movhdi/buck/شماتیک مدار اصلی قدرت مبدل باک.png

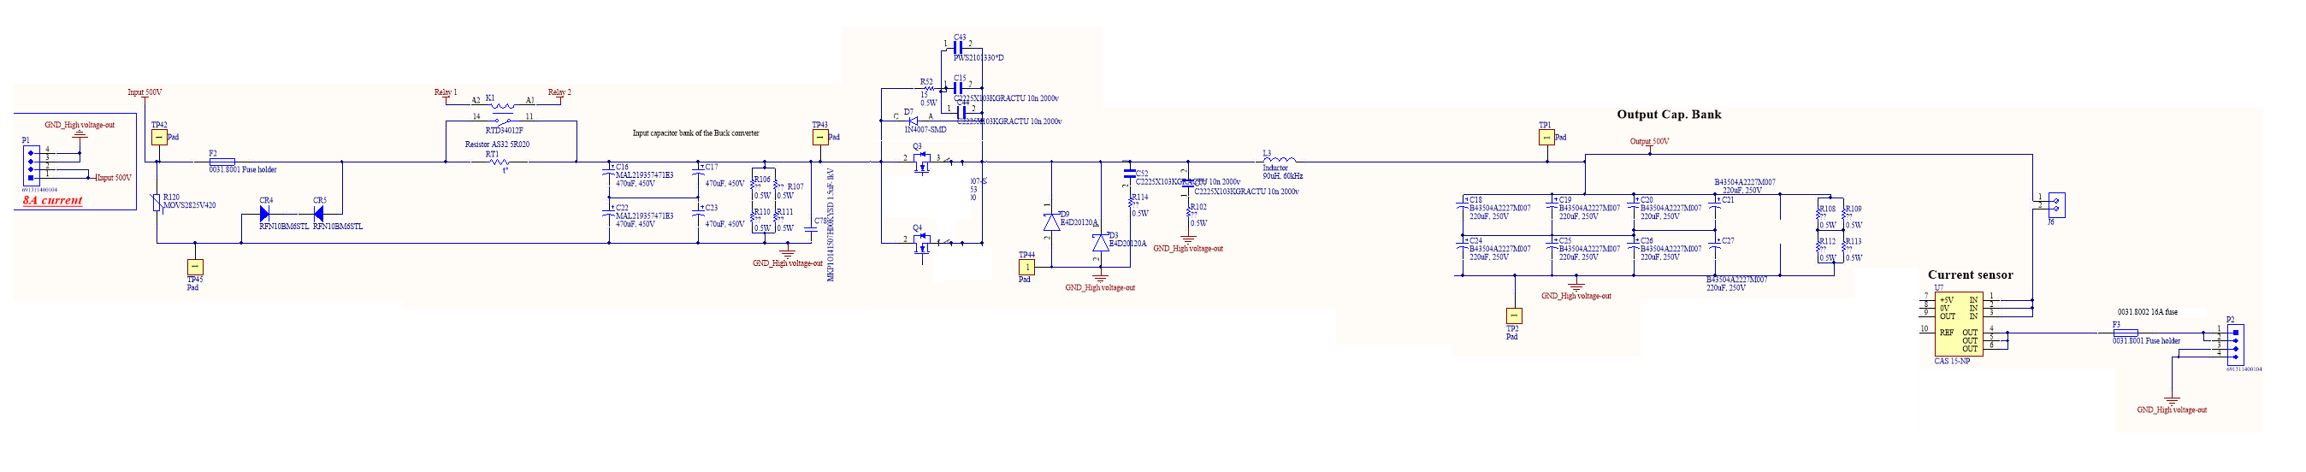
شماتیک مدار اصلی قدرت مبدل باک.png
