movhdi/buck/Final BOM 23.12.2022 for Library.xls

Sheet: Buck Converter
Pos | Count | Name | Type | Package (inch) | Value | Description | Manufacturer | Manuf. Part Number | Distributor | Distributor - PartNumber
1 | 4 | C1, C2, C9, C10 | SMD MLCC | 0805 | 1nF, 50V, X7R, 10% | Capacitor | Samsung | CL21B103KBANFNC | Mouser (https://www.mouser.de/ProductDetail/Samsung-Electro-Mechanics/CL21B103KBANFNC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) | 187-CL21B103KBANFNC
2 | 10 | C3, C4, C6, C8, C13, C14, C29, C30, C42, C71 | SMD MLCC | 0805 | 100nF, 50V, X7R, 10% | Capacitor | Kyocera AVX | 08055C104KAT2A | Mouser (https://www.mouser.de/ProductDetail/KYOCERA-AVX/08055C104KAT2A?qs=2ujN4bDBNE9mJvapP%252BjopA%3D%3D) | 581-08055C104K
3 | 4 | C5, C7, C11, C12 | SMD MLCC | 0805 | 100pF, 1000V, C0G, 10% | Capacitor | Kemet | C0805C101KDGACAUTO | Mouser (https://www.mouser.de/ProductDetail/KEMET/C0805C101KDGACAUTO?qs=ds50AKTGxA%252BLPSx5ZuVIbw%3D%3D) | 80-C0805C101KDGAUTO
4 | 4 | C15, C44, C52, C77 | SMD MLCC | 2225 (5664 metric) | 10nF, 2000V, X7R, 10% | Capacitor | Kemet | C2225X103KGRACTU | Mouser (https://www.mouser.de/ProductDetail/KEMET/C2225X103KGRACTU?qs=QuKtCJqbFLqTW8HohInyGA%3D%3D) | 80-C2225X103KGR
5 | 4 | C16, C17, C22, C23 | Polarized Capacitor | 35 x 50 mm (axial) | 470uF, 450V | Alu-Elektrolytkondensatoren - einrastend | Vishay | MAL219357471E3 | Mouser (https://www.mouser.de/ProductDetail/Vishay-BC-Components/MAL219357471E3?qs=GedFDFLaBXHGPbG7as%2FOlA%3D%3D) | 594-MAL219357471E3
6 | 8 | C18, C19, C20, C21, C24, C25, C26, C27 | Polarized Capacitor | 22 x 30 mm (axial) | 220uF, 250V, 20% | Alu-Elektrolytkondensatoren - einrastend | Epcos / TDK | B43504A2227M007 | Mouser (https://www.mouser.de/ProductDetail/EPCOS-TDK/B43504A2227M007?qs=f4aWRLuQiuw%2FgInPUHtBEw%3D%3D) | 871-B43504A2227M007
7 | 25 | C28, C34, C35, C36, C37, C38, C39, C40, C47, C48, C53, C54, C55, C56, C57, C58, C60, C61, C62, C63, C64, C66, C67, C68, C69 | Polarized Capacitor | 6.3 x 5.3mm | 47uF, 16V, 20% | Alu-Elektrolytkondensatoren - SMD | Elna | RV2-16V470MU-R | Mouser (https://www.mouser.de/ProductDetail/Elna/RV2-16V470MU-R?qs=qcv5MX6YzaIJgZHNch8VAQ%3D%3D) | 555-RV2-16V470MU-R
8 | 13 | C31, C32, C46, C49, C50, C51, C59, C65, C70, C72, C73, C74, C75 | SMD MLCC | 0805 | 10uF, 16V, X5R, 10% | Capacitor | Murata | GRM21BR61C106KE15K | Mouser (https://www.mouser.de/ProductDetail/Murata-Electronics/GRM21BR61C106KE15K?qs=h0WOCFF19ULjTOS37upAEw%3D%3D) | 81-GRM21BR61C106KE5K
9 | 2 | C33, C45 | SMD MLCC | 0805 | 10uF, 50V, X5R, 10% | Capacitor | Murata | GRM21BR61H106KE43L | Mouser (https://www.mouser.de/ProductDetail/Murata-Electronics/GRM21BR61H106KE43L?qs=lYGu3FyN48cBZlIduWKclg%3D%3D) | 81-GRM21BR61H106KE3L
10 | 1 | C41 | SMD MLCC | 0805 | 1uF, 50V, X7R, 10% | Capacitor | Taiyo Yuden | UMK212B7105KG-T | Mouser (https://www.mouser.de/ProductDetail/Taiyo-Yuden/UMK212B7105KG-T?qs=PzICbMaShUdi76GLXMVYcA%3D%3D) | 963-UMK212B7105KG-T
11 | 1 | C43 | Ceramic disk capacitor | 7 x 19 mm (axial) | 3.3n, 1kV, PP, 10% | Snubber Cap, Cylindrical | Nichicon | PWS2101330KD | Mouser (https://www.mouser.de/ProductDetail/Nichicon/PWS2101330KD?qs=sPbYRqrBIVn4hkQwaqNb3g%3D%3D) | 647-PWS2101330KD
12 | 5 | C70, C72, C73, C74, C75 | Foil Capacitor THT | 13 x 4 x 9 mm | 2.2nF, 1.5kV dc, 300V AC | Safety-Capacitor, LS = 10 mm | Kemet | R413F122050T0K | Mouser (https://www.mouser.de/ProductDetail/KEMET/R413F122050T0K?qs=W%2FMpXkg%252BdQ6FJTi7bF3iHQ%3D%3D) | 80-R413F122050T0K
13 | 1 | C76 | SMD MLCC | 1206 (3216 metric) | 4.7uF, 25V, X7R, ±10% | Capacitor | Kyocera AVX | 12063C475KAT4A | Mouser (https://www.mouser.de/ProductDetail/KYOCERA-AVX/12063C475KAT4A?qs=MOd%2Fd18ARG8tU6mY4RG1ag%3D%3D) | 581-12063C475KAT4A
14 | 1 | C78 | Foil Capacitor THT | Radial 2 pin straight 37.5mm spacing | 1.5uF, 1kV | Radial | WIMA | MKP1O141507H00KYSD | https://www.mouser.de/ProductDetail/WIMA/MKP1O141507H00KYSD?qs=iPPgFPFs9POFYINu54f%252BeQ%3D%3D | 505-M101.5/1KV/10
15 | 6 | CR1, CR3, CR6, CR7, CR8, CR9 | TVS Diode | DO-214AA-2 | 48volts 5uA 7.7 Amps | Uni-Dir | Bourns | SMBJ48A | Mouser (https://www.mouser.de/ProductDetail/Bourns/SMBJ48A?qs=%252Bf8Cd6aE5bwjzO1D5yl1DQ%3D%3D) | 652-SMBJ48A
16 | 1 | CR2 | Diode | DO-214AB (SMC) | 5A 40V | Schottky Dioden & Gleichrichter | Diodes Incorporated | B540C-13-F | https://www.mouser.de/ProductDetail/Diodes-Incorporated/B540C-13-F?qs=v2dnQLbuoRZXHN%2FK4ft5%252Bg%3D%3D | 621-B540C-F
17 | 2 | CR4, CR5 | Diode | TO-252-2 | 600V, 10A, 1.25V | Gleichrichter | ROHM Semiconductor | RFN10BM6STL | Mouser (https://www.mouser.de/ProductDetail/ROHM-Semiconductor/RFN10BM6STL?qs=yrxrYnY23DGgbKuawv2xDA%3D%3D) | 755-RFN10BM6STL
18 | 2 | D1, D4 | Zener Diode | SOD-123FL | 39V, 10µA, 1W, 10 mA | High Power, 5% | ROHM Semiconductor | KDZVTR39A | Mouser (https://www.mouser.de/ProductDetail/ROHM-Semiconductor/KDZVTR39A?qs=bZr6mbWTK5mINS6QZuiknQ%3D%3D) | 755-KDZVTR39A
19 | 6 | D2, D7, D8, D10, D11, D12 | Diode | DO-214AC (SMA) | 1000V 1A | Diode Standard | Vishay | S1M-E3/61T | https://www.mouser.de/ProductDetail/Vishay-General-Semiconductor/S1M-E3-61T?qs=lBalI7KQBwr3jNdZI%2F8iCw%3D%3D | 625-S1M-E3
20 | 2 | D3, D9 | Diode | TO-220-2 | 20 AMP, 1200V | Schottky Dioden & Gleichrichter SiC | Wolfspeed | E4D20120A | Mouser (https://www.mouser.de/ProductDetail/Wolfspeed/E4D20120A?qs=w%2Fv1CP2dgqo%2FknITVfcWWQ%3D%3D) | 941-E4D20120A
21 | 2 | D5, D6 | Schottky Diode | DO-221AD-2 (SMB) | 5A, 120V | Diode Standard | Vishay | VSS8D5M12HM3/H | Mouser (https://www.mouser.de/ProductDetail/Vishay-General-Semiconductor/VSS8D5M12HM3-H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) | 78-VSS8D5M12HM3/H
22 | 10 | DS1,DS2, DS3, DS4, DS5, DS6, DS7, DS8, DS9 | Blue LED SMD | 0805 (2012 metric) | 3.2V, 20mA, 470nm | Top View, 145 mcd, 140 deg, 105mW, 1.25 x 2.00mm | Würth | 150080BS75000 | Mouser (https://www.mouser.de/ProductDetail/Wurth-Elektronik/150080BS75000?qs=2kOmHSv6VfT2tBo3UPVqAQ%3D%3D) | 710-150080BS75000
23 | 1 | EC2 | Board Connector | 80 Pins x 2 Rows | 2.8A | 0.8MM HIGH SPEED ASSEMBLY | Samtec | HSEC8-160-01-L-RA-BL | Mouser (https://www.mouser.de/ProductDetail/Samtec/HSEC8-160-01-L-RA-BL?qs=PB6%2FjmICvI1gEqaIZPg%252B4Q%3D%3D) | 200-HSEC816001LRABL
24 | 2 | F2, F3 | Fuse holder | 5 mm x 20 mm | 10A, 600V | OG FUSEHOLDER 5X20 | Schurter | 0031.8001 | Digikey (https://www.digikey.de/de/products/detail/schurter-inc/0031-8001/2644437?s=N4IgTCBcDaIAxwMwEYB0AOByQF0C%2BQA) | 486-1992-ND
25 | 10 | FB1, FB2, FB3, FB4, FB5, FB6, FB7, FB8, FB9, FB10 | Ferrite Bead | 0201 (0603 metric) | 0.18 Ohm, 520mA, 25% | EMI-Suppression Ferrite Bead | TDK | MMZ0603S800HTD25 | Mouser (https://www.mouser.de/ProductDetail/TDK/MMZ0603S800HTD25?qs=5aG0NVq1C4zguuq0nplFrQ%3D%3D) | 810-MMZ0603S800HTD25
26 | 4 | J1, J2, J3, J6 | Fixed Terminal Blocks | pitch 5mm, 2P Straight | 250VAC 16A | WR-TBL Series 101 Horizontal Entry Modular, THT | Würth | 691101710002 | Mouser (https://www.mouser.de/ProductDetail/Wurth-Elektronik/691101710002?qs=7gQLVZk5cPko2q9q3mYFyQ%3D%3D) | 710-691101710002
27 | 1 | J4 | D-SUB-Connector | 25 Pins, 2 Rows | Female, Straight, THT | WR-DSUB Female PCB Connector | Würth | 61802525123 | Mouser (https://www.mouser.de/ProductDetail/Wurth-Elektronik/61802525123?qs=ZtY9WdtwX57NPP3pCOssIQ%3D%3D) | 710-61802525123
28 | 1 | J5 | D-SUB-Connector | 15 Pins, 2 Rows | Female, Straight, THT | WR-DSUB Female PCB Connector | Würth | 61801525123 | Mouser (https://www.mouser.de/ProductDetail/Wurth-Elektronik/61801525123?qs=ZtY9WdtwX55glhDCqAc0Jg%3D%3D) | 710-61801525123
29 | 1 | K1 | Relay | 29 x 12.7 x 15.7 mm | SPST-NO 16 A 12 VDC | RELAY GEN PURPOSE | TE Connectivity | RTD34012F | Mouser (https://www.mouser.de/ProductDetail/TE-Connectivity-PB/RTD34012F?qs=xBghIHTbXkif3RDRm%2FBtiA%3D%3D) | 655-RTD34012F
30 | 1 | OK1 | Fiber Optic Connection | 4-Pin | 660 nm, 40 kBd | Versatile Fiber Optic Connection | Broadcom | HFBR-2533Z | Mouser (https://www.mouser.de/ProductDetail/Broadcom-Avago/HFBR-2533Z?qs=jT9z6tsiFNk65rmydPk8Cg%3D%3D) | 630-HFBR-2533Z
31 | 2 | P1, P2 | PCB Header | 4-Pin, 7.62 mm | 300VAC 20A Vertical | WR-TBL Serie 3114 - Close Vertical PCB Header | Würth | 691311400104 | Mouser (https://www.mouser.de/ProductDetail/Wurth-Elektronik/691311400104?qs=E2PpAYvlWVteo26mZsjDSg%3D%3D) | 710-691311400104
32 | 2 | P3, P4 | PCB Header | 2.54 mm, 4 Pin | Shrouded, Straight, THT | Male Header, Height 12.8 mm, Tail Length 3.5 mm | TE Connectivity | 280371-2 | Mouser (https://www.mouser.de/ProductDetail/TE-Connectivity/280371-2?qs=NCegfZXRvjgzX%2FK7rtD32w%3D%3D) | 571-280371-2
33 | 2 | Q1, Q2 | Optocoupler | SSO-8 | 1 ch, 6V max, 5000V iso | IC OPAMP ISOLATION 100KHZ | Broadcom | ACPL-C87A-500E | RS (https://de.rs-online.com/web/p/optokoppler/1744121) | 174-4121
34 | 2 | Q3, Q4 | N-Channel Transistor | TO247-3 | 95 A, 1.2 kV, 0.022 ohm | Siliziumkarbid-MOSFET, CoolMOS Power | ROHM Semiconductor | SCT3022KLHRC11 | Farnell (https://de.farnell.com/rohm/sct3022klhrc11/mosfet-n-kanal-1-2kv-95a-175-c/dp/3052186?st=sct3022klhrc11) | 3052186
35 | 1 | Q5 | Digital NPN-Transistor | SC-75-3 | 100mA 50V | Digital Transistor (BRT), R1=4.7 kOhm, R2=47 kOhm | onsemi | DTC143ZET1G | Mouser (https://www.mouser.de/ProductDetail/onsemi/DTC143ZET1G?qs=2OtswVQKCOGWcFMBzaldrg%3D%3D) | 863-DTC143ZET1G
36 | 80 | R1, R2, R26, R28, R43, R44, R86, R87, R92, R93, 'R3, R4, R5, R6, R7, R8, R9, R10, R11, R12, R13, R14, R15, R16, R17, R18, R19, R20, R21, R22, R23, R24, R25, R27, R29, R30, R33, R34, R35, R36, R37, R38, R39, R40, R41, R42, R45, R46, R47, R48, R49, R50, R60, R61,R62, R83, R84, R85, R121R88, R89, R90, R91, R94, R95, R97, R129 | SMD Thickfilm-Resistor | 0805 | 0 Ohm | Res SMD | 0 Ohm size 0805 | RC0805FR-070RL | https://www.mouser.de/ProductDetail/YAGEO/RC0805FR-070RL?qs=fRxXYNj8ftF6kXqh1XbZJQ%3D%3D | 603-RC0805FR-070RL
37 | 23 | R31, R32, R55, R56, R57, R59, R63, R64, R66, R71, R72, R73, R74, R76, R78, R79, R115, R116, R117, R118, R119, R130, R131, Rj1, Rj2, Rj3, Rj4, Rj5, Rj6, Rj7, Rj8, Rj9, Rj10, Rj11, Rj12 | SMD Thickfilm-Resistor | 0603, 100mW | 0 Ohm, 100mW | Res SMD | Bourns | CR0603AJ/-000EAS | Mouser (https://www.mouser.de/ProductDetail/Bourns/CR0603AJ-000EAS?qs=PzGy0jfpSMtRj%252B7fJP4d3A%3D%3D) | 652-CR0603AJ/-000EAS
38 | 5 | R51, R96, R98, R99, R122 | SMD Thickfilm-Resistor | 0805, 125mW | 15k Ohm, 1%, 100ppm/°C | Res SMD | Vishay | CRCW080515K0FKEBC | Mouser (https://www.mouser.de/ProductDetail/Vishay-Dale/CRCW080515K0FKEBC?qs=wd5RIQLrsJhoqkW23VWcpg%3D%3D) | 71-CRCW080515K0FKEBC
39 | 2 | R52 | Metal-Film-Resistor, THT | 6.5 x 2.5 mm, 0.5W | 15 Ohm, 1%, 100ppm/°C | Res Semi | Vishay | SFR25H0001509FR500 | Mouser (https://www.mouser.de/ProductDetail/Vishay-BC-Components/SFR25H0001509FR500?qs=LCMWAU1DZcwPtbGDC9uu6w%3D%3D) | 594-5053HD15R00F
40 | 3 | R53, R54, R126 | SMD Thickfilm-Resistor | 0805, 0.5W | 100 Ohm, 1%, 100ppm/°C | Res SMD | Bourns | CHP0805AFX-1000ELF | Mouser (https://www.mouser.de/ProductDetail/Bourns/CHP0805AFX-1000ELF?qs=BJlw7L4Cy7%252BkJgcu88J9nA%3D%3D) | 652-CHP0805AFX1000EL
41 | 2 | R58, R65 | SMD Thickfilm-Resistor | MELF 500mW 5.9mm | MELF Resistors 1.4ohm 1% 1/2WS Melf Metal Film | Res SMD | YAGEO | MMF50SFRE1R4 | https://www.mouser.de/ProductDetail/YAGEO/MMF50SFRE1R4?qs=gt1LBUVyoHl9ZtaYFTMqGA%3D%3D | 603-MMF50SFRE1R4
42 | 5 | R68, R70, R80, R81, R82 | SMD Thickfilm-Resistor | 0805, 125mW | 1k Ohm, 1%, 100ppm/°C | Res SMD | Vishay | RCA08051K00FKEA | Mouser (https://www.mouser.de/ProductDetail/Vishay-Draloric/RCA08051K00FKEA?qs=WyvL69DJJa9VdBCx4Aidbg%3D%3D) | 71-RCA08051K00FKEA
43 | 2 | R75, R77 | SMD Thickfilm-Resistor | 0805, 0.5W | 300 Ohm, 1% | Res SMD | Vishay | CRCW0805300RFKEAHP | Mouser (https://www.mouser.de/ProductDetail/Vishay-Dale/CRCW0805300RFKEAHP?qs=GBLSl2AkirthAJDNnhYDBA%3D%3D) | 71-CRCW0805300RFKEAH
44 | 4 | R100, R101, R132, R133 | SMD Thickfilm-Resistor | 0805, 125mW | 10K OHM 0.5% 1/8W 0805 | Res SMD | Yageo | RC0805DR-0710KL | https://www.digikey.de/en/products/detail/yageo/RC0805DR-0710KL/5918468 | 13-RC0805DR-0710KLTR-ND
45 | 2 | R103, R105 | SMD Thickfilm-Resistor | 0805, 0.33W | 12 Ohm, 1%, 100ppm/°C | Res SMD | TE Connectivity | CRGH0805F12R | Mouser (https://www.mouser.de/ProductDetail/TE-Connectivity-Holsworthy/CRGH0805F12R?qs=gt1LBUVyoHlGbP0sv8GK4g%3D%3D) | 279-CRGH0805F12R
46 | 1 | R104 | SMD Thickfilm-Resistor | 0805, 0.25W | 47.5k Ohm, 1%, 100ppm/°C | Res SMD | Yageo | AC0805FR-7W47K5L | Mouser (https://www.mouser.de/ProductDetail/YAGEO/AC0805FR-7W47K5L?qs=mQk0km4IMDfdlvbcCTKLmA%3D%3D) | 603-AC0805FR-7W47K5L
47 | 1 | R120 | Varistor | 2825 | 420V ac, 1120V CLAMP | Res Varistor (Voltage-Sensitive Resistor), 400 PEA | Bussmann | MOVS2825V420 | Mouser (https://www.mouser.de/ProductDetail/Bussmann-Eaton/MOVS2825V420?qs=CiayqK2gdcL8V7kvp27eBw%3D%3D) | 504-MOVS2825V420
48 | 4 | R124, R125, R127, R128 | SMD Thickfilm-Resistor | 0805, 0.5W | 4.7k Ohm, 1%, 100ppm/°C | Res SMD | Vishay | CRCW08054K70FKEAHP | Mouser (https://www.mouser.de/ProductDetail/Vishay-Dale/CRCW08054K70FKEAHP?qs=k2%2FDWSARqgEa%252B2IrxOkJMA%3D%3D) | 71-CRCW08054K70FKEAH
49 | 3 | R134, R135, R136 | SMD Thickfilm-Resistor | 0805, 125mW | 3.3k Ohm, 1%, 100ppm/°C | Res SMD | Bourns | CR0805-FX-3301ELF | Mouser (https://www.mouser.de/ProductDetail/Bourns/CR0805-FX-3301ELF?qs=4vGXhLEMbUy96oT8I4L5Pg%3D%3D) | 652-CR0805FX-3301ELF
50 | 1 | RT1 | INRSH CURR LIMITER | 30mm x 8.2 mm | 5ohms 20A, 25% | Thermistor, LS = 17.1mm | Ametherm | AS32 5R020 | Mouser (https://www.mouser.de/ProductDetail/Ametherm/AS32-5R020?qs=PVyXUKBeRH03xAkowf7bwg%3D%3D) | 995-AS32-5R020
51 | 1 | S1 | Miniature Switch | 18 x 11 x 7 mm | 3A, 125V ac | SW-SPDT , Right Angle Mounting, Vertical Actuation | NKK Switches | EB2011-CA | Mouser (https://www.mouser.de/ProductDetail/NKK-Switches/EB2011-CA?qs=9GeSZTU0FRBJNK85x%2Fwr5g%3D%3D) | 633-EB2011CA
52 | 1 | Trans1 | Fiber Optic Transceiver | 7.6 x 12.2 x 18.8 mm | 6-Pin THD, 5V | The Versatile Fiber Optic Connection, 660nm, 1MBd, POF | Broadcom | HFBR-1522Z | Mouser (https://www.mouser.de/ProductDetail/Broadcom-Avago/HFBR-1522Z?qs=jT9z6tsiFNn%252B67id87SREQ%3D%3D) | 630-HFBR-1522Z
53 | 2 | U1, U2 | Operational Amplifier | 8-pin DIP (P8) | 8 to 44 V, 3.3mA | Ultra-Low Noise Precision, 1 Channel, 8 MHz, 25mA | Texas Instruments | OPA27GP | Mouser (https://www.mouser.de/ProductDetail/Texas-Instruments/OPA27GP?qs=7nS3%252BbEUL6tjaFP1rKzqLQ%3D%3D) | 595-OPA27GP
54 | 1 | U3 | DC-DC Converter | 25.4 x 25.4 mm | 9-36(24V nom) -> 15V, 1A out | 15W, 1500VDC Iso, overload and short circuit protection | Texim Europe | MJWI15-24S15 | Texim-europe (https://www.texim-europe.com/product/MJWI15-24S15-MIN) | MJWI15-24S15-MIN
55 | 1 | U4 | EMI-Filter | 12 x 8 mm, radial | 25V 15A | LC-Filter, 40 dB, LEADED, 100kHz - 1 GHz | Murata | BNX016-01 | Mouser (https://www.mouser.de/ProductDetail/Murata-Electronics/BNX016-01?qs=wcegd7B9MGv5f1vSnNmbeg%3D%3D) | 81-BNX016-01
56 | 2 | U5, U6, U12 | DC-DC Converter | 25.4 x 25.4 mm | 9-36(24V nom) -> 5V, 3A out | 15W, 1500VDC Iso, overload and short circuit protection | Texim Europe | MJWI15-24S05 | Texim-europe (https://www.texim-europe.com/product/MJWI15-24S05-MIN) | MJWI15-24S05-MIN
57 | 1 | U7 | Current Transducer | 10-Pin THD | 4.75V - 5.25V, 15A AC/DC | SENSOR CURRENT FLUX, 300kHz, 1% | LEM USA Inc. | CAS 15-NP | Digikey (https://www.digikey.de/de/products/detail/lem-usa-inc/CAS-15-NP/2038401) | 398-1088-5-ND
58 | 3 | U8, U14, U15 | Schmitt Trigger Buffer | SOT-23-5 | 1.65V - 5.5V, ± 32mA | IC BUF NON-INVERT | Texas Instruments | SN74LVC1G17DBVT | Mouser (https://www.mouser.de/ProductDetail/Texas-Instruments/SN74LVC1G17DBVT?qs=pajgIaoyDUjLdDGl76l3mA%3D%3D) | 595-SN74LVC1G17DBVT
59 | 1 | U9 | Gate Opto Driver | SDIP-6 | 5-30V, 30mA | 4.0 A Isolated Gate Drivers, 5 kVRMS Isolation Rating | Skyworks Solutions | SI8261BBD-C-ISR | Mouser (https://www.mouser.de/ProductDetail/Skyworks-Solutions-Inc/SI8261BBD-C-ISR?qs=j6MGy4L9yX3EvnVCCLOfkQ%3D%3D) | 634-SI8261BBD-C-ISR
60 | 1 | U10 | Low-Side Gate Driver | 8-Pin SOIC (SI) | 4.5 to 35 V | 9-Ampere, Ultrafast MOSFET Driver, 200 kOhm | IXYS Integrated | IXDN609SIATR | Mouser (https://www.mouser.de/ProductDetail/IXYS-Integrated-Circuits/IXDN609SIATR?qs=8uBHJDVwVqzogRpgL3z3VA%3D%3D) | 849-IXDN609SIATR
61 | 1 | U11 | LDO Voltage-Regulator | 5-pin DPAK (Q-5) | 2.7 to 20 V in -> 3.3 V out | 3 A, Fast Transient Response, Low Noise | Analog Devices | LT1764AEQ-3.3#TRPBF | Mouser (https://www.mouser.de/ProductDetail/Analog-Devices/LT1764AEQ-3.3TRPBF?qs=ytflclh7QUVo8QnKetIRUw%3D%3D) | 584-1764AEQ-3.3TRPBF
62 | 2 | U16, U17 | Opto Transistor Photocoupler | SMD-4 | 80V, 2.5mA | Ausgangsoptokoppler, 5000V Iso, NPN, 100-600%, 10mA | Sharp Microelectronics | PC81713NIP1B | Mouser (https://www.mouser.de/ProductDetail/Sharp-Microelectronics/PC81713NIP1B?qs=rrS6PyfT74eNHbzqPCYSng%3D%3D) | 852-PC81713NIP1B
63 | 1 | U18 | Isolated Amplifier | SOIC-8 | 3 - 5.5V, 7.1mA | 2-V input, reinforced, with high CMTI for voltage sensing | Texas Instruments | AMC1311BDWV | Mouser (https://www.mouser.de/ProductDetail/Texas-Instruments/AMC1311BDWV?qs=W0yvOO0ixfEO6UxTvn5eHA%3D%3D) | 595-AMC1311BDWV
64 | 1 | U19 | Operational Amplifier | SOT-23-5 | 1.8 - 3.6V, 650 µA | Single, RRIO, 23mA out, 8MHz | Texas Instruments | TLV2781IDBVR | Mouser (https://www.mouser.de/ProductDetail/Texas-Instruments/TLV2781IDBVR?qs=m96fseALk3WX0toeCkj9wg%3D%3D) | 595-TLV2781IDBVR
65 | 1 | U19 | Operational Amplifier | SOT-23-5 | 2.2 - 5V, 1.03 mA | Single, 23.7 mA, 10MHz | Texas Instruments | LMV721IDBVR | https://www.digikey.de/en/products/detail/texas-instruments/LMV721IDBVR/1510625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 | 595-LMV721IDBVR
66 | 2 |  | NTC Temp sensor | 3 x 40 mm | 5Kohms 3984K / 0.5% | NTC-Thermistor, 3% Tol | Vishay | NTCLE413E2502H400A | Mouser (https://www.mouser.de/ProductDetail/Vishay-BC-Components/NTCLE413E2502H400A?qs=vLWxofP3U2xQ7QI4zcTPNQ%3D%3D) | 594-NTL413E2502H400A
67 | 1 |  | DC-Fan 12V | 40x10mm | Tubeaxial Fan | DC-Lüfter, Ball Bearing, Lead Wires | Delta Electronics | AFB0412VHA-A |  | 108-AFB0412VHA-A
68 | 1 |  | Heatsink | 75 x 46 mm | for TO-220 | HEATSINK ALUM ANOD | Assmann WSW Components | V5583G | Digikey (https://www.digikey.de/de/products/detail/assmann-wsw-components/V5583G/3511512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) | AE10815-ND
69 | 1 |  | Fan power supply | SIP8 | 18 - 36V -> 12V, 250mA | DC-DC Converter, 1500V Iso, 3W, 22 x 9.5 x 12mm | aimtec | AM3G-2412S-NZ | TME (https://www.tme.eu/en/details/am3g-2412s-nz/dc-dc-converters/aimtec/) | AM3G-2412S-NZ
70 | 1 |  | AC-DC 12V power supply | 109 x 52 x 33,5mm | 85 - 264V AC -> 12V, 5A out | AC/DC CONVERTER 60W | Mean Well USA Inc | IRM-60-12ST | Digikey (https://www.digikey.de/de/products/detail/mean-well-usa-inc/IRM-60-12ST/7704693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) | 1866-3064-ND
71 | 1 |  | Main inductor core | 57.15mm outer diameter | 26.39mm inner diameter | Micrometals Hi-Flux Alloy, Permeability: 60, AL Value: 138 | ARNOLD POWDER CORES | HF-226060-2 | Powermagneticsstore (https://powermagneticsstore.co.uk/shop/hf-226060-2-arnold-powder-cores.html) | HF-226060-2

Sheet: Connectors
Connectors |  |  |  | V0.1 | REV0 | new Design of Synantik | 2022-Dec-21 |  | PCB: 4-layer, FR4, 1,5mm, 35µmCu, Finish: HAL, Vias: open, SolderStop:green, PositionPrintTop:tNames+tDocu+tPlace (white) PositionPrintBottom:none |  |  | Amount of PCBs: | 2
Pos | Count | Name | Type | Package (inch) | Value | Description | Manufacturer | Manuf. Part Number | Distributor | Distributor - PartNumber | Comment | Price / Piece | Order | Price
1 |  |  |  |  |  |  |  |  |  |  |  |  |  | 0.00 €
2 |  |  |  |  |  |  |  |  |  |  |  |  |  | 0.00 €
3 |  |  |  |  |  |  |  |  |  |  |  |  |  | 0.00 €
4 |  |  |  |  |  |  |  |  |  |  |  |  |  | 0.00 €
5 |  |  |  |  |  |  |  |  |  |  |  |  |  | 0.00 €
6 |  |  |  |  |  |  |  |  |  |  |  |  |  | 0.00 €
7 |  |  |  |  |  |  |  |  |  |  |  |  |  | 0.00 €
8 |  |  |  |  |  |  |  |  |  |  |  |  |  | 0.00 €
9 |  |  |  |  |  |  |  |  |  |  |  |  |  | 0.00 €
10 |  |  |  |  |  |  |  |  |  |  |  |  |  | 0.00 €
 |  |  |  |  |  |  |  |  |  |  |  |  | Gesamtpreis für 6 Platinen: | 0.00 €
 |  | Project Info
 |  | Project: | 3.3 kW - Buck Converter
 |  | PCB: | Buck-Converter.PrjPcb
 |  | Change-Log:
 |  | Changes:
 |  | PosEdit:
 |  | PosDel:
 |  | PosAdd:
 |  | PosNew:
 |  | Board:
 |  | Layout:
