movhdi/buck/(list of files, drawings)

Other design files:
AC-DC Power supply-V1.0.PcbDoc
AC-DC Power supply.PrjPcb
AC-DC Power supply.SchDoc
Buck-14.SchDoc
Buck-15.SchDoc
Buck-V1.0.PcbDoc
Buck.PcbLib
Buck.PrjPcb
Buck.SCHLIB
PcbLib1.PcbLib
