movhdi/buck/(commit log)

2022-12-21 first commit
    Schematic and design notes
    [BOM 19.12.2022.xlsx, Buck-14.SchDoc]
2022-12-23 added some footprint to Buck-14 schematic.
    [Buck-14.SchDoc]
2022-12-23 added final sch and bom
    [Buck-15.SchDoc, Final BOM 23.12.2022 for Library.xls]
2022-12-23 created projects
    [AC-DC Power supply-V1.0.PcbDoc, AC-DC Power supply.PrjPcb, AC-DC Power supply.SchDoc, Buck-15.SchDoc, Buck-V1.0.PcbDoc, Buck.PcbLib, Buck.PrjPcb]
2022-12-24 adding footprints U4 U7 U8, U14, U15 U10 U11 U16, U17
    [AC-DC Power supply-V1.0.PcbDoc, AC-DC Power supply.SchDoc, Buck-15.SchDoc, Buck-V1.0.PcbDoc, Buck.PrjPcb, Final BOM 23.12.2022 for Library.xls, PcbLib1.PcbLib]
2022-12-24 project saved!
    [Buck.PrjPcb]
2022-12-24 created Libs folder and download some footprints: EC2 F2 J4 J5 K1 OK1 P1 P3 Q1 Q5
2022-12-25 MJWI15-24S05 footprint created
    [Buck.PrjPcb, PcbLib1.PcbLib]
2022-12-25 U5 U6 U12 footprint added
    [Buck-15.SchDoc, Buck-V1.0.PcbDoc, Buck.PcbLib, Buck.PrjPcb, Final BOM 23.12.2022 for Library.xls]
2022-12-25 added some footprints
    [Buck-15.SchDoc, Buck-V1.0.PcbDoc, Buck.PcbLib]
2022-12-27 edited AC-DC Power supply schematic and update to pcb.
    created symbols and footprints for IRM-60-12ST and BNX016-01
    [AC-DC Power supply-V1.0.PcbDoc, AC-DC Power supply.PrjPcb, AC-DC Power supply.SchDoc, Buck.PcbLib]
2022-12-27 created the rest of footprint components and update to pcb.
    created the Buck.SCHLIB
    [Buck-15.SchDoc, Buck.PcbLib, Buck.SCHLIB]
2022-12-27 regulator SCH symbol and footprint added, Buck inductor footprint added, and placement of BUCK input stage started. Heatsink screw holes remained to be done.
    [AC-DC Power supply.PrjPcb, Buck-15.SchDoc, Buck.PcbLib, Buck.SCHLIB, Final BOM 23.12.2022 for Library.xls]
2022-12-30 some placement
    [Buck-15.SchDoc, Buck.PcbLib]
2022-12-30 modified schematic and update to pcb.
    u4, u20
    [Buck-15.SchDoc, Buck.PcbLib, Buck.SCHLIB]
2022-12-31 placement continued. (inside company)
    [AC-DC Power supply-V1.0.PcbDoc, Buck-15.SchDoc]
2022-12-31 Placement progressed more.
    [AC-DC Power supply-V1.0.PcbDoc, Buck-15.SchDoc, Buck.PrjPcb]
2022-12-31 modified current sensor sch and pcb
    add datasheets folder
    [Buck-15.SchDoc, Buck.PcbLib, Buck.PrjPcb, Buck.SCHLIB]
2023-01-01 placement continued. inside company.
    [Buck-15.SchDoc]
2023-01-01 Last steps of placement
    [Buck-15.SchDoc]
2023-01-02 Trying to reduce the size of the board.
2023-01-02 Last placements from Movahedi.
    [Buck-15.SchDoc]
2023-01-02 modified placement and schematic
    [AC-DC Power supply-V1.0.PcbDoc, Buck-15.SchDoc, Buck.PcbLib]
2023-01-06 Routing and draw polygons
    [AC-DC Power supply-V1.0.PcbDoc, Buck-15.SchDoc, Buck.PcbLib]
2023-01-06 add name of board in pcb.
    [AC-DC Power supply-V1.0.PcbDoc]
2023-01-20 PCBLib updated with the heatsink of "FullBridge Heatsink component"
    [Buck.PcbLib]
2023-01-26 Full bridge inductor added to buck.pcblib
    [Buck.PcbLib, Buck.PrjPcb]
2023-01-26 modified Full Bridge Heat sink and Full bridge inductor
    [Buck.PcbLib]
2023-01-27 modified hole size and pad of 61802525123
    [Buck.PcbLib]
2023-01-27 modified hole size and pad of REC52415SRWZH6A
    [Buck.PcbLib]
2023-01-28 modified the Full bridge inductor
    add transformer
    [Buck.PcbLib]
2023-02-03 current sensor LEM footprint corrected.
    [Buck.PcbLib]
